josephcabrera-cmyk/Claritone/hardware/schematic/Claritone_Schematic.pdf

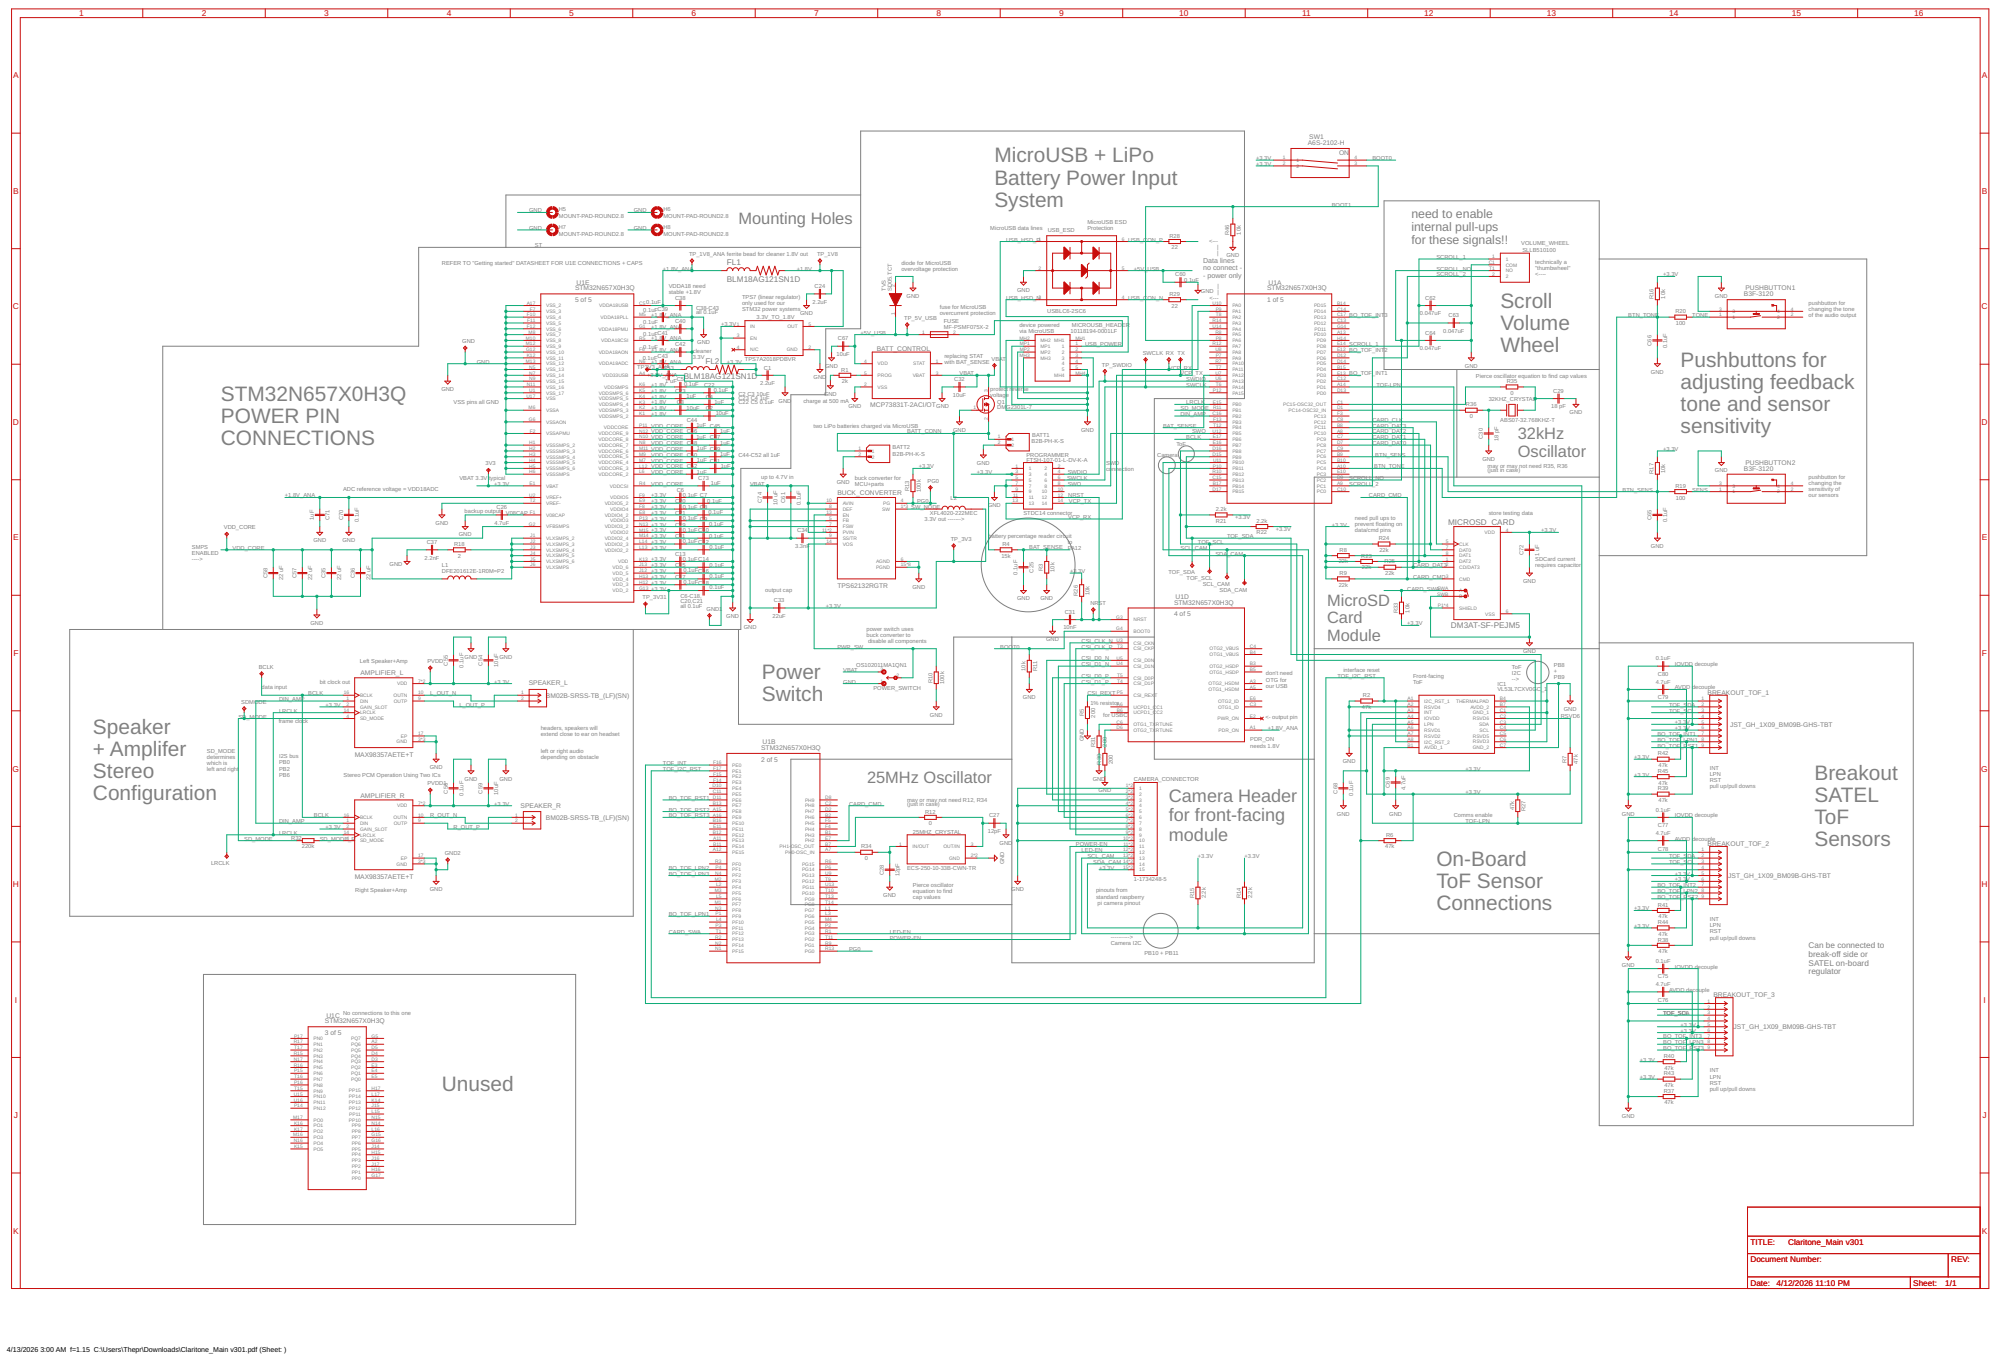
[picture p8: page 1]

ferrite bead for cleaner 1.8V out

REFER TO "Getting started" DATASHEET FOR U1E CONNECTIONS + CAPS

TPS7 (linear regulator)
only used for our STM32 power systems

pushbutton for changing the tone

of the audio output

Pierce oscillator equation to find cap values

VSS pins all GND

two LiPo batteries charged via MicroUSB

may or may not need R35, R36
(just in case)

buck converter for MCU+parts

pushbutton for changing the

need pull ups to
prevent floating on
data/cmd pins

battery percentage reader circuit

SDCard current requires capacitor

don't need
OTG for our USB

headers, speakers will
extend close to ear on headset

left or right audio
depending on obstacle

Stereo PCM Operation Using Two ICs

may or may not need R12, R34

Pierce oscillator equation to find

PF13 R2 | POWER-EN | ----------> Camera I2C PB10 + PB11
PF14 N2 | PG0

Can be connected to
break-off side or
SATEL on-board
regulator

Document Number: | REV:

Date: Date: 4/12/2026 11:10 PM 4/12/2026 11:10 PM | Sheet: Sheet: 1/1 1/1

4/13/2026 3:00 AM f=1.15 C:\Users\Thepr\Downloads\Claritone_Main v301.pdf (Sheet: )
