josephcabrera-cmyk/Claritone/hardware/schematic/Claritone_PCB_BOTTOM.pdf

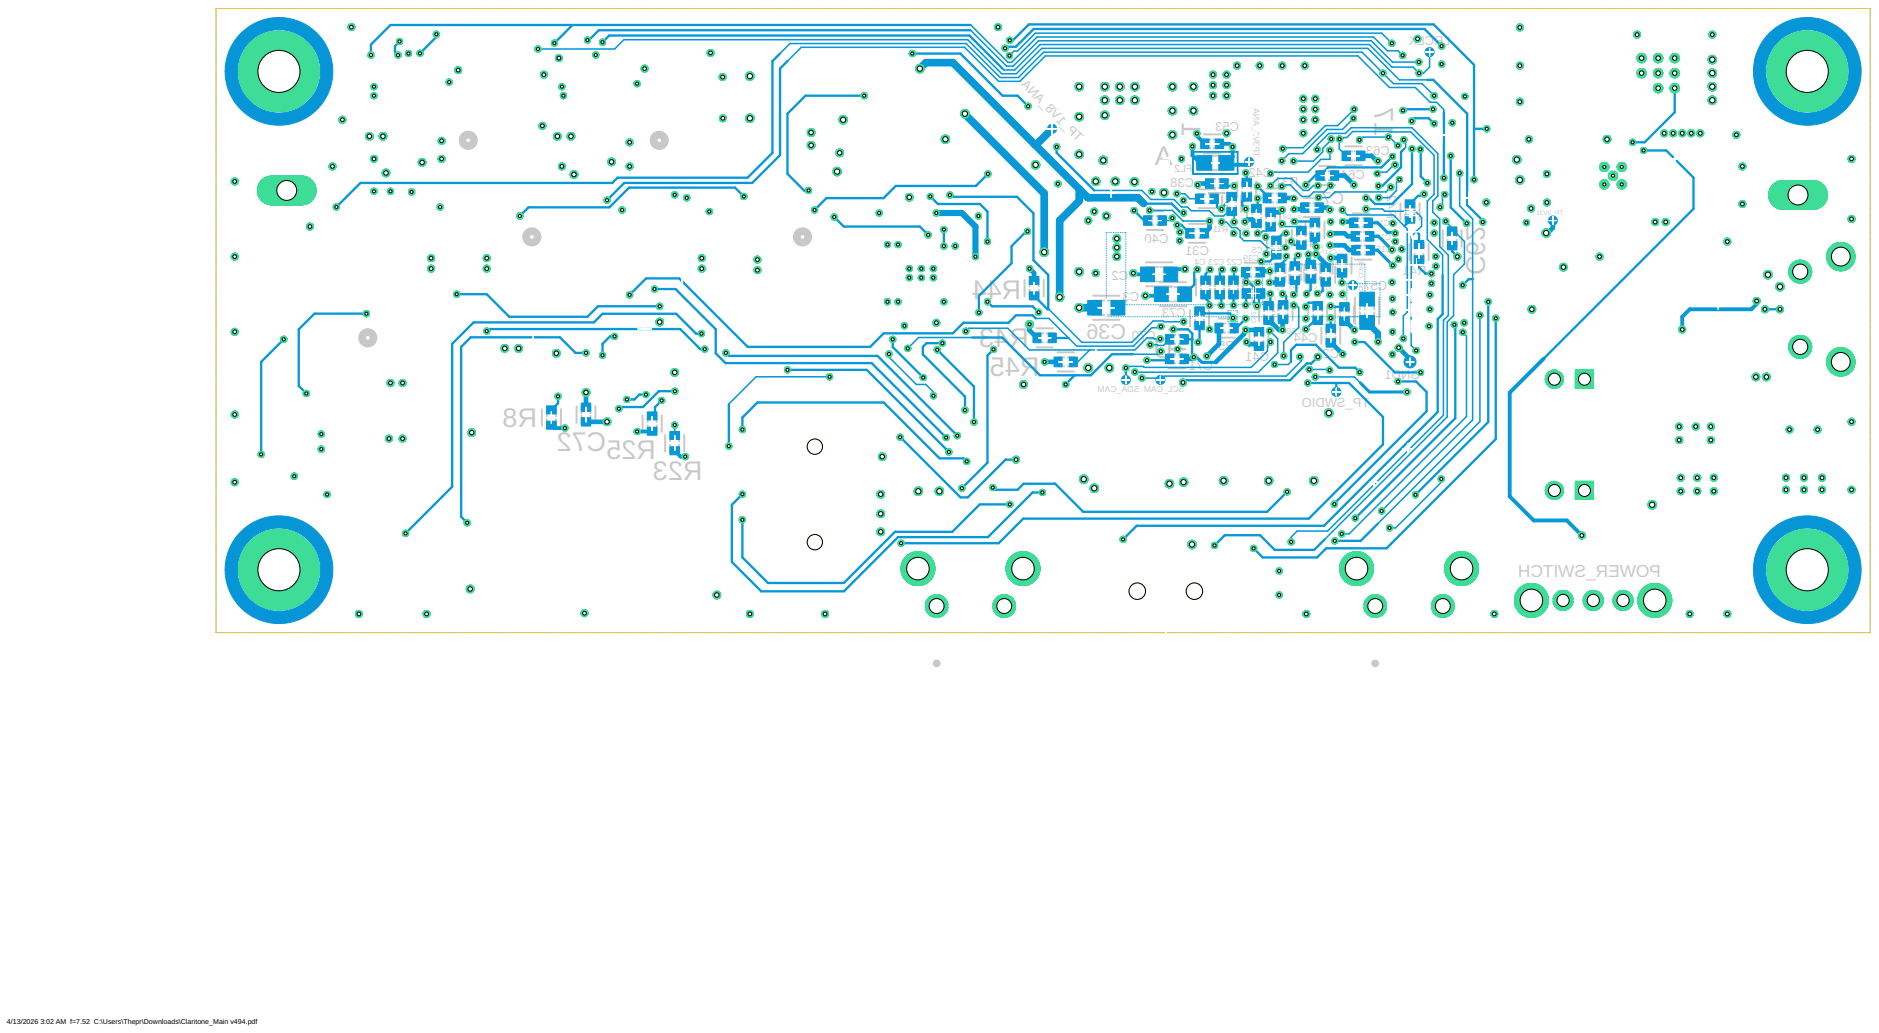
[picture p9: page 1]

4/13/2026 3:02 AM f=7.52 C:\Users\Thepr\Downloads\Claritone_Main v494.pdf
