josephcabrera-cmyk/Claritone/hardware/schematic/Claritone_PCB_TOP.pdf

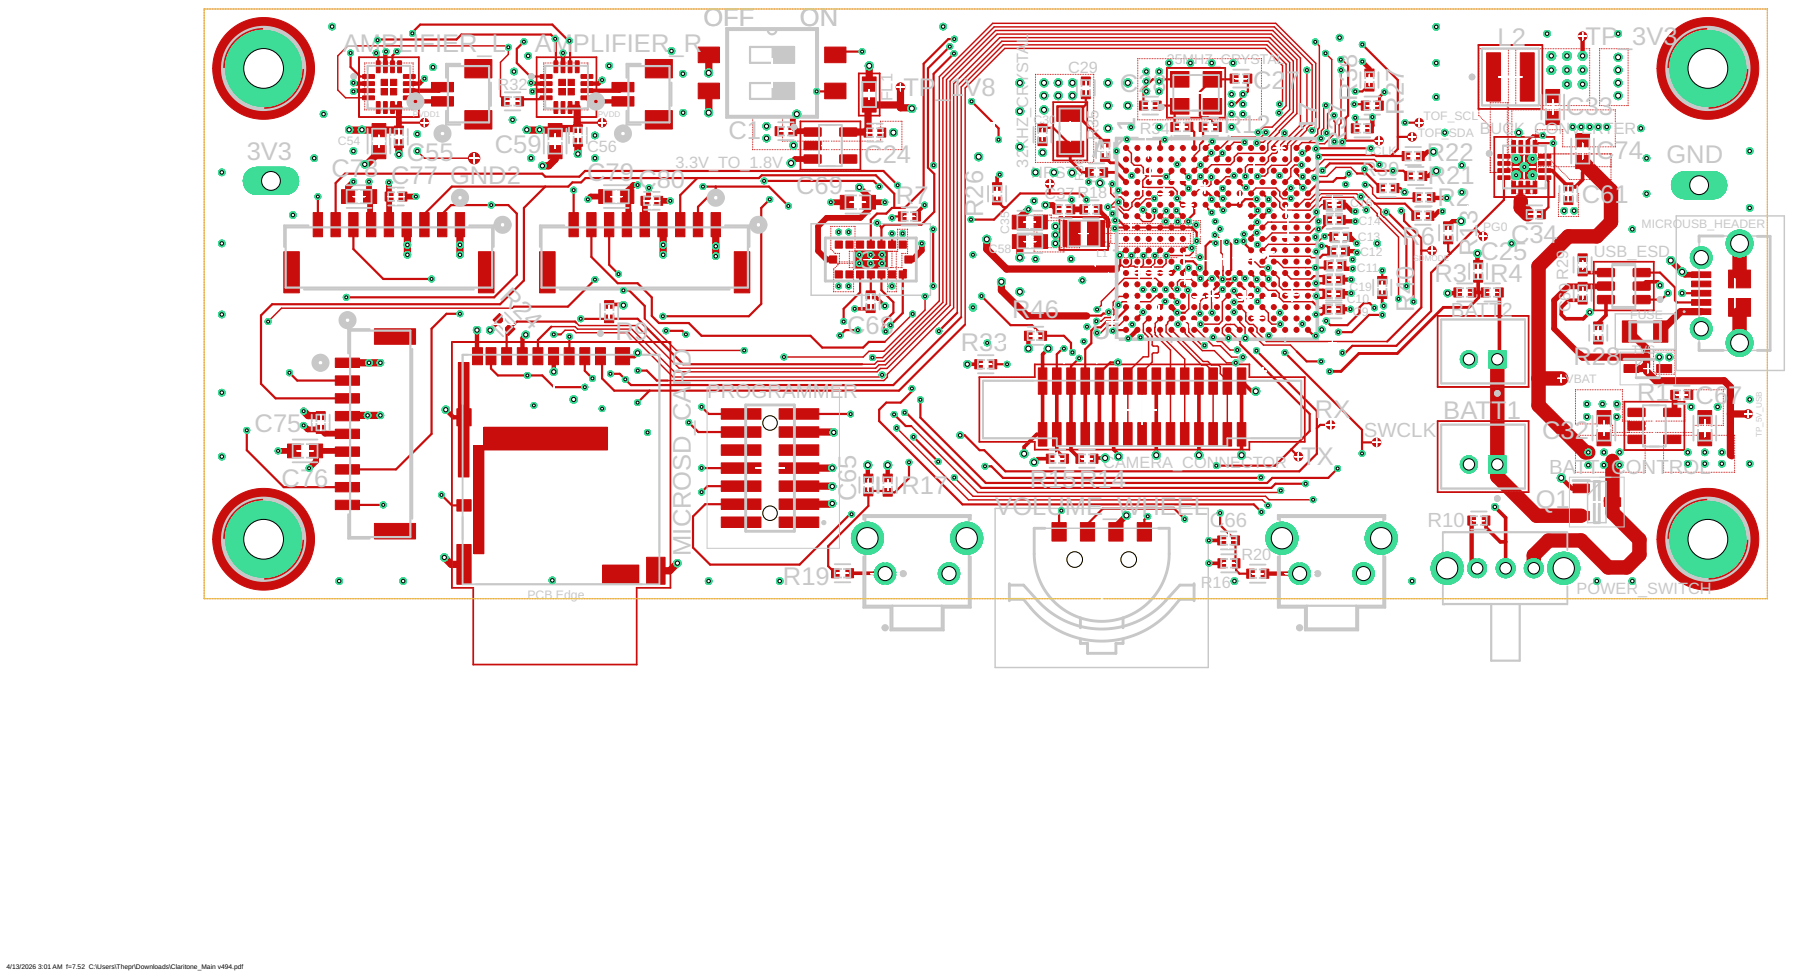
[picture p10: page 1]

4/13/2026 3:01 AM f=7.52 C:\Users\Thepr\Downloads\Claritone_Main v494.pdf
