josephcabrera-cmyk/Claritone/hardware/source/Claritone_Main.brd

## EAGLE design hardware/source/Claritone_Main.brd (2026-10-22)

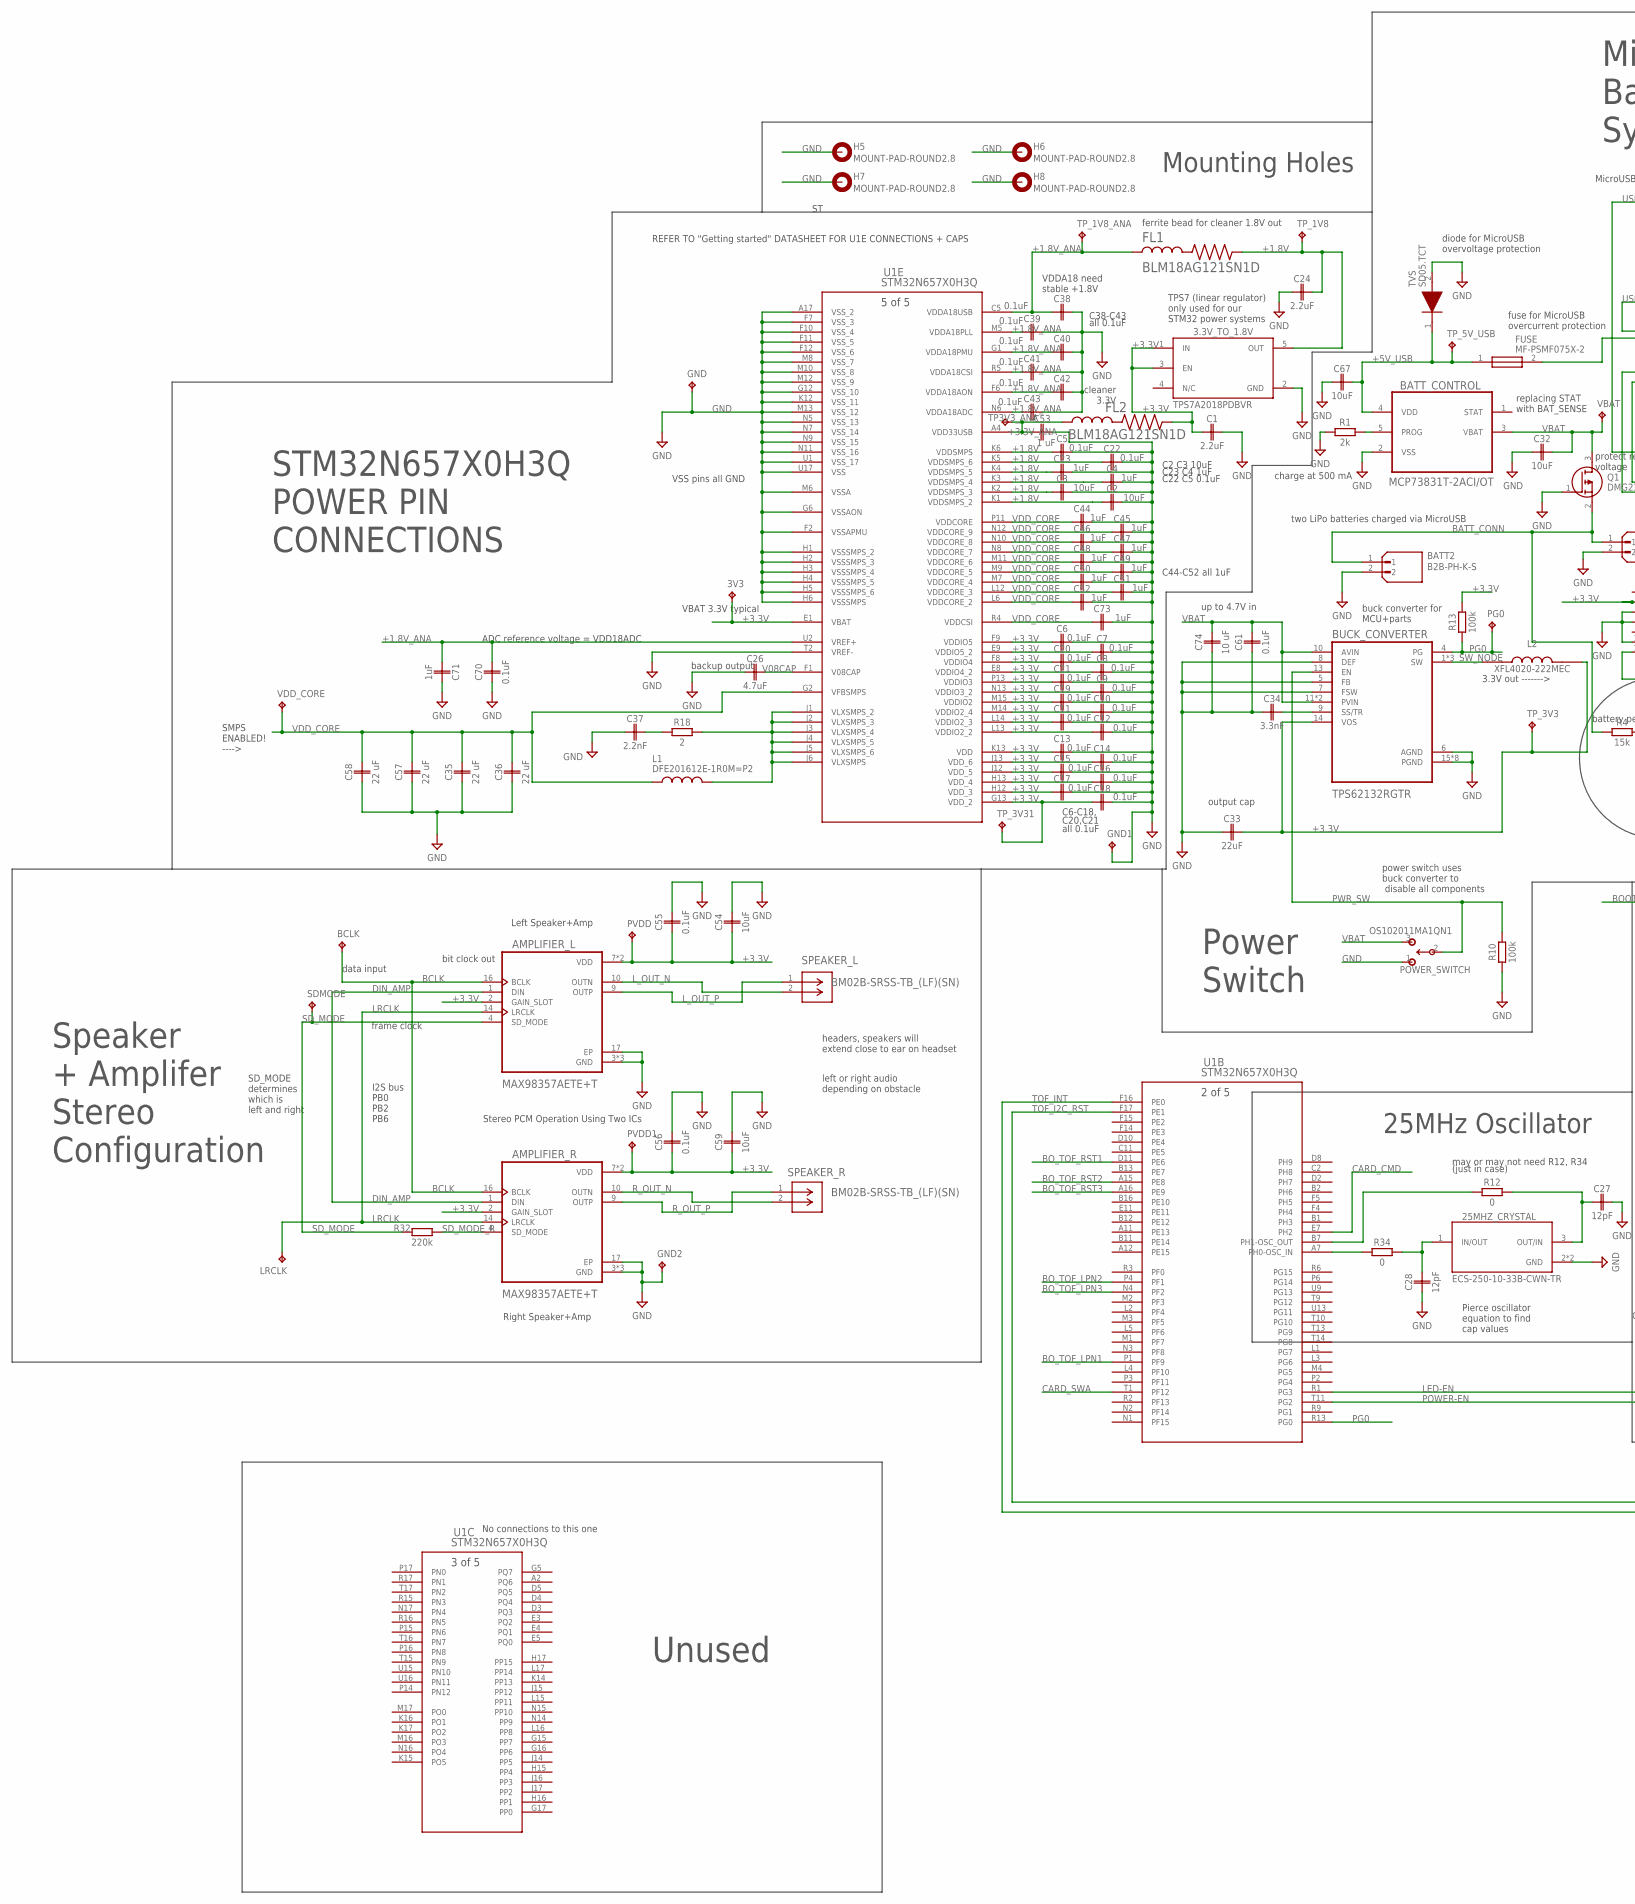
[picture p11: schematic Claritone_Main.sch, part in row 1, column 1]

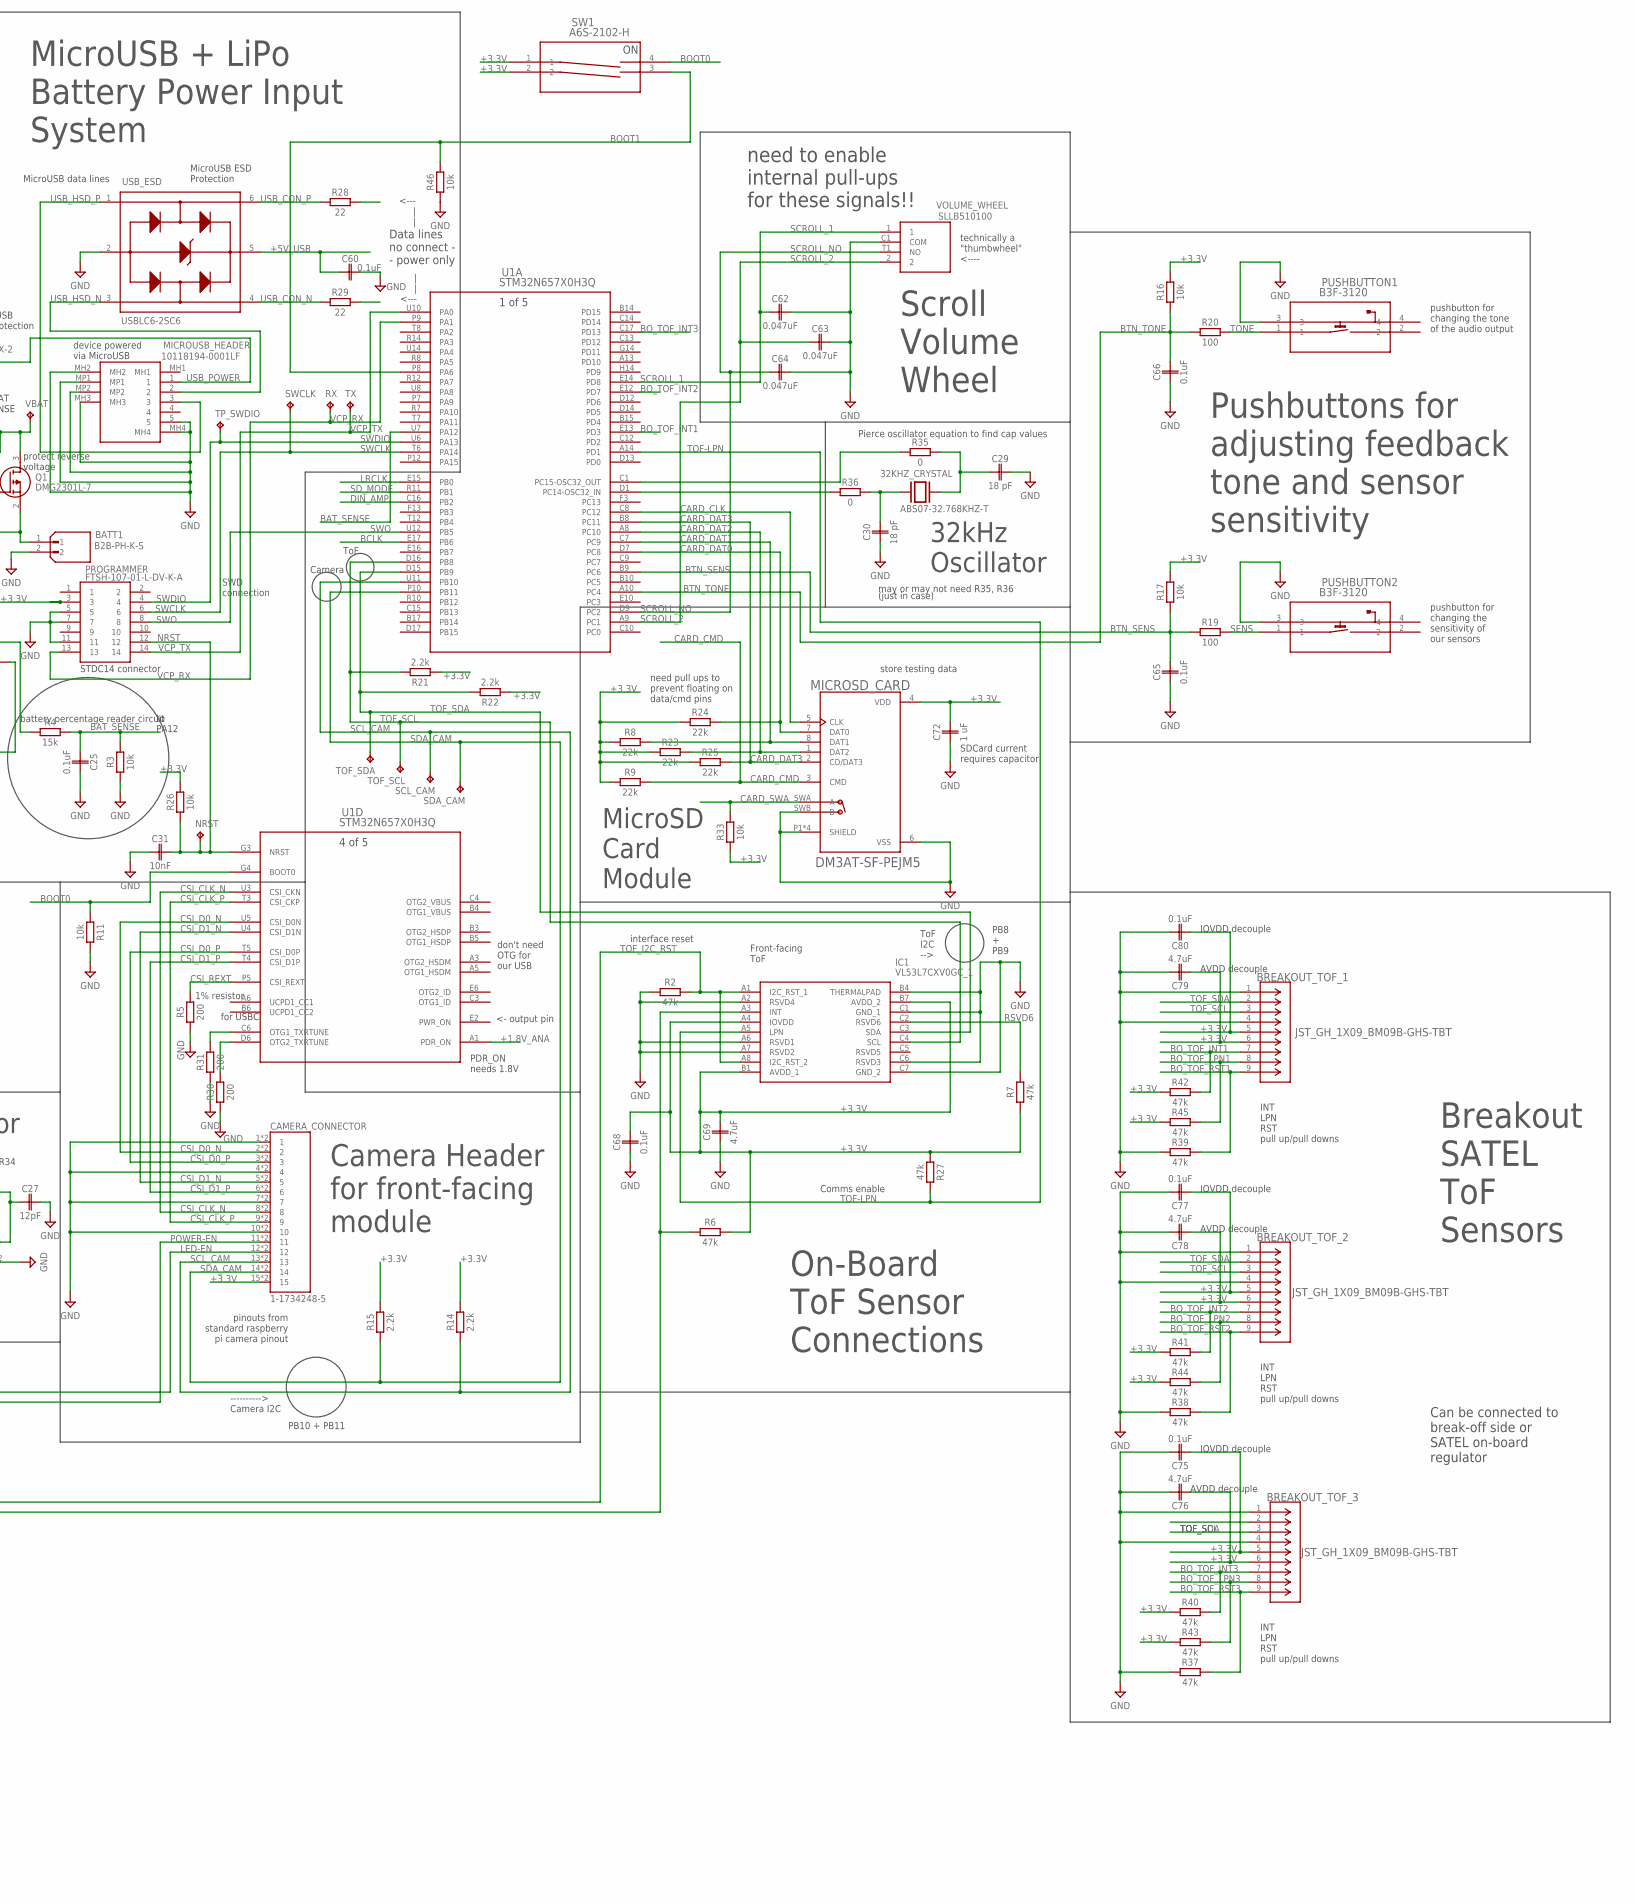
[picture p12: schematic Claritone_Main.sch, part in row 1, column 2]

Parts:
3.3V_TO_1.8V: TPS7A2018PDBVR; SOT95P280X145-5N(3)
3V3: TPPAD1-13Y; P1-13Y
25MHZ_CRYSTAL: ECS-250-10-33B-CWN-TR; XTAL_ECS-250-10-33B-CWN-TR
32KHZ_CRYSTAL: ABS07-32.768KHZ-T; XTAL_ABS07-32.768KHZ-T
AMPLIFIER_L: MAX98357AETE+T; QFN50P300X300X80-17N
AMPLIFIER_R: MAX98357AETE+T; QFN50P300X300X80-17N
BATT1, BATT2: B2B-PH-K-S; JST_B2B-PH-K-S
BATT_CONTROL: MCP73831T-2ACI/OT; SOT95P280X145-5N(1)
BCLK: TPTP06R; TP06R
BREAKOUT_TOF_1, BREAKOUT_TOF_2, BREAKOUT_TOF_3: JST_GH_1X09_BM09B-GHS-TBT; CONN_BM09B-GHS-TBT_JST
BUCK_CONVERTER: TPS62132RGTR; QFN50P300X300X100-17N
C1, C24: 2.2uF; CAPC1005X60
C2, C3, C32, C54, C59, C67: 10uF; CAPC1608X85
C4, C23, C44, C45, C46, C47, C48, C49, C50, C51, C52, C71, C73: 1uF; CAPC1005X60
C5, C6, C7, C8, C9, C10, C11, C12, C13, C14, C15, C16, C17, C18, C19, C20, C21, C22, C25, C38, C39, C40, C41, C42, C43, C55, C56, C60, C61, C65, C66, C68, C70, C75, C77, C80: 0.1uF; CAPC1005X60
C26: 4.7uF; CAPC1005X60
C27, C28: 12pF; CAPC1005X60
C29, C30: 18 pF; CAPC1005X60
C31: 10nF; CAPC1005X60
C33: 22uF; CAPC1608X85
C34: 3.3nF; CAPC1005X60
C35, C36, C57, C58: 22 uF; CAPC1608X85
C37: 2.2nF; CAPC1005X60
C53, C72: 1 uF; CAPC1005X60
C62, C63, C64: 0.047uF; CAPC1005X60
C69, C76, C78, C79: 4.7uF; CAPC1608X85
C74: 10 uF; CAPC1608X85
CAMERA_CONNECTOR: 1-1734248-5; TE_1-1734248-5
FL1, FL2: BLM18AG121SN1D; BEADC1608X95N
FUSE: MF-PSMF075X-2; MFPSMF075X2
GND: TPPAD1-13Y; P1-13Y
GND1, GND2: TPTP08R; TP08R
H5, H6, H7, H8: MOUNT-PAD-ROUND2.8; 2,8-PAD
IC1: VL53L7CXV0GC_1; VL53L7CXV0GC1
L1: DFE201612E-1R0M=P2; INDC2016X120N
L2: XFL4020-222MEC; IND_XFL4020-222MEC
LRCLK: TPTP06R; TP06R
MICROSD_CARD: DM3AT-SF-PEJM5; HRS_DM3AT-SF-PEJM5
MICROUSB_HEADER: 10118194-0001LF; 101181940001LF
NRST: TPTP06R; TP06R
PG0: TPTP06R; TP06R
POWER_SWITCH: OS102011MA1QN1; SWITCH_11MA1QN1
PROGRAMMER: FTSH-107-01-L-DV-K-A; FTSH-107-XX-YYY-DV-K-A
PUSHBUTTON1, PUSHBUTTON2: B3F-3120; SW_B3F-3120_OMR
PVDD, PVDD1: TPTP06R; TP06R
Q1: DMG2301L-7; SOT96P240X115-3N
R1: 2k; RESC1005X40
R2, R6, R7, R27, R37, R38, R39, R40, R41, R42, R43, R44, R45: 47k; RESC1005X40
R3, R11, R16, R17, R26, R33, R46: 10k; RESC1005X40
R4: 15k; RESC1005X40
R5, R30, R31: 200; RESC1005X40
R8, R9, R23, R24, R25: 22k; RESC1005X40
R10, R13: 100k; RESC1005X40
R12, R34, R35, R36: 0; RESC1005X40
R14, R15, R21, R22: 2.2k; RESC1005X40
R18: 2; RESC1005X40
R19, R20: 100; RESC1005X40
R28, R29: 22; RESC1005X40
R32: 220k; RESC1005X40
RX: TPTP06R; TP06R
SCL_CAM: TPTP06R; TP06R
SDA_CAM: TPTP06R; TP06R
SDMODE: TPTP06R; TP06R
SPEAKER_L: BM02B-SRSS-TB_(LF)(SN); CONN_BM02B-SRSS-TB_JST
SPEAKER_R: BM02B-SRSS-TB_(LF)(SN); CONN_BM02B-SRSS-TB_JST
SW1: A6S-2102-H; SW_A6S-2102-H_OMR
SWCLK: TPTP06R; TP06R
TOF_SCL: TPTP06R; TP06R
TOF_SDA: TPTP06R; TP06R
TP3V3_ANA: TPTP06R; TP06R
TP_1V8, TP_1V8_ANA, TP_3V3, TP_3V31, TP_5V_USB: TPTP06R; TP06R
TP_SWDIO: TPTP06R; TP06R
TVS: SD05.TCT; SOD2513X110N
TX: TPTP06R; TP06R
U1: STM32N657X0H3Q; VFBGA264_14X14_STM
USB_ESD: USBLC6-2SC6; SOT95P280X145-6N
VBAT: TPTP06R; TP06R
VDD_CORE: TPTP06R; TP06R
VOLUME_WHEEL: SLLB510100

Connections:
+1.8V: 3.3V_TO_1.8V.5 (OUT), C2.1, C3.1, C4.1, C5.1, C22.1, C23.1, C24.2, FL1.2, TP_1V8.TP, U1.K1 (VDDSMPS_2), U1.K2 (VDDSMPS_3), U1.K3 (VDDSMPS_4), U1.K4 (VDDSMPS_5), U1.K5 (VDDSMPS_6), U1.K6 (VDDSMPS)
+1.8V_ANA: C38.1, C39.1, C40.1, C41.1, C42.1, C43.1, C70.2, C71.1, FL1.1, TP_1V8_ANA.TP, U1.A1 (PDR_ON), U1.C5 (VDDA18USB), U1.F6 (VDDA18AON), U1.G1 (VDDA18PMU), U1.M5 (VDDA18PLL), U1.N6 (VDDA18ADC), U1.R5 (VDDA18CSI), U1.U2 (VREF+)
+3.3V: 3.3V_TO_1.8V.1 (IN), 3.3V_TO_1.8V.3 (EN), 3V3.TP, AMPLIFIER_L.2 (GAIN_SLOT), AMPLIFIER_L.7 (VDD), AMPLIFIER_L.8 (VDD), AMPLIFIER_R.2 (GAIN_SLOT), AMPLIFIER_R.7 (VDD), AMPLIFIER_R.8 (VDD), BREAKOUT_TOF_1.5, BREAKOUT_TOF_1.6, BREAKOUT_TOF_2.5, BREAKOUT_TOF_2.6, BREAKOUT_TOF_3.5, BREAKOUT_TOF_3.6, BUCK_CONVERTER.14 (VOS), C1.1, C6.1, C7.1, C8.1, C9.1, C10.1, C11.1, C12.1, C13.1, C14.1, C15.1, C16.1, C17.1, C18.1, C19.1, C20.1, C21.1, C33.2, C54.1, C55.1, C56.1, C59.1, C68.2, C69.2, C72.2, C75.1, C76.1, C77.1, C78.1, C79.1, C80.1, CAMERA_CONNECTOR.15, CAMERA_CONNECTOR.15_1 (15), FL2.2, IC1.A4 (IOVDD), IC1.B1 (AVDD_1), IC1.B7 (AVDD_2), L2.2, MICROSD_CARD.4 (VDD), PROGRAMMER.3, PVDD.TP, PVDD1.TP, R6.2, R7.1, R8.1, R9.1, R13.2, R14.2, R15.2, R16.2, R17.2, R21.1, R22.1, R23.1, R24.1, R25.1, R26.2, R27.1, R33.1, R40.1, R41.1, R42.1, R43.1, R44.1, R45.1, SW1.1, SW1.2, TP_3V3.TP, TP_3V31.TP, U1.E1 (VBAT), U1.E8 (VDDIO4_2), U1.E9 (VDDIO5_2), U1.F8 (VDDIO4), U1.F9 (VDDIO5), U1.G13 (VDD_2), U1.H12 (VDD_3), U1.H13 (VDD_4), U1.J12 (VDD_5), U1.J13 (VDD_6), U1.K13 (VDD), U1.L13 (VDDIO2_2), U1.L14 (VDDIO2_3), U1.M14 (VDDIO2_4), U1.M15 (VDDIO2), U1.N13 (VDDIO3_2), U1.P13 (VDDIO3)
+3.3V_ANA: C53.1, FL2.1, TP3V3_ANA.TP, U1.A4 (VDD33USB)
+5V_USB: BATT_CONTROL.4 (VDD), C60.1, C67.2, FUSE.1, TP_5V_USB.TP, TVS.1 (K), USB_ESD.5 (VBUS)
BATT_CONN: BATT1.1, BATT2.1, Q1.2 (S), R4.1
BAT_SENSE: C25.1, R3.2, R4.2, U1.U7 (PA12)
BCLK: AMPLIFIER_L.16 (BCLK), AMPLIFIER_R.16 (BCLK), BCLK.TP, U1.E17 (PB6)
BOOT0: R11.1, SW1.4, U1.G4 (BOOT0)
BOOT1: R46.2, SW1.3, U1.P8 (PA6)
BO_TOF_INT1: BREAKOUT_TOF_1.7, R42.2, U1.E13 (PD3)
BO_TOF_INT2: BREAKOUT_TOF_2.7, R41.2, U1.E12 (PD7)
BO_TOF_INT3: BREAKOUT_TOF_3.7, R40.2, U1.C17 (PD13)
BO_TOF_LPN1: BREAKOUT_TOF_1.8, R45.2, U1.P1 (PF9)
BO_TOF_LPN2: BREAKOUT_TOF_2.8, R44.2, U1.P4 (PF1)
BO_TOF_LPN3: BREAKOUT_TOF_3.8, R43.2, U1.N4 (PF2)
BO_TOF_RST1: BREAKOUT_TOF_1.9, R39.2, U1.D11 (PE6)
BO_TOF_RST2: BREAKOUT_TOF_2.9, R38.2, U1.A15 (PE8)
BO_TOF_RST3: BREAKOUT_TOF_3.9, R37.2, U1.A16 (PE9)
BTN_SENS: C65.2, R17.1, R19.1, U1.B9 (PC6)
BTN_TONE: C66.2, R16.1, R20.1, U1.A10 (PC4)
CARD_CLK: MICROSD_CARD.5 (CLK), U1.C8 (PC12)
CARD_CMD: MICROSD_CARD.3 (CMD), R9.2, U1.E7 (PH2)
CARD_DAT0: MICROSD_CARD.7 (DAT0), R24.2, U1.D7 (PC8)
CARD_DAT1: MICROSD_CARD.8 (DAT1), R8.2, U1.C7 (PC9)
CARD_DAT2: MICROSD_CARD.1 (DAT2), R23.2, U1.A8 (PC10)
CARD_DAT3: MICROSD_CARD.2 (CD/DAT3), R25.2, U1.B8 (PC11)
CARD_SWA: MICROSD_CARD.SWA (A), R33.2, U1.T1 (PF12)
CSI_CLK_N: CAMERA_CONNECTOR.8, CAMERA_CONNECTOR.8_1 (8), U1.U3 (CSI_CKN)
CSI_CLK_P: CAMERA_CONNECTOR.9, CAMERA_CONNECTOR.9_1 (9), U1.T3 (CSI_CKP)
CSI_D0_N: CAMERA_CONNECTOR.2, CAMERA_CONNECTOR.2_1 (2), U1.U5 (CSI_D0N)
CSI_D0_P: CAMERA_CONNECTOR.3, CAMERA_CONNECTOR.3_1 (3), U1.T5 (CSI_D0P)
CSI_D1_N: CAMERA_CONNECTOR.5, CAMERA_CONNECTOR.5_1 (5), U1.U4 (CSI_D1N)
CSI_D1_P: CAMERA_CONNECTOR.6, CAMERA_CONNECTOR.6_1 (6), U1.T4 (CSI_D1P)
CSI_REXT: R5.2, U1.P5 (CSI_REXT)
DIN_AMP: AMPLIFIER_L.1 (DIN), AMPLIFIER_R.1 (DIN), U1.C16 (PB2)
GND: 3.3V_TO_1.8V.2 (GND), 25MHZ_CRYSTAL.2 (GND), 25MHZ_CRYSTAL.4 (GND), AMPLIFIER_L.3 (GND), AMPLIFIER_L.11 (GND), AMPLIFIER_L.15 (GND), AMPLIFIER_L.17 (EP), AMPLIFIER_R.3 (GND), AMPLIFIER_R.11 (GND), AMPLIFIER_R.15 (GND), AMPLIFIER_R.17 (EP), BATT1.2, BATT2.2, BATT_CONTROL.2 (VSS), BREAKOUT_TOF_1.1, BREAKOUT_TOF_1.4, BREAKOUT_TOF_2.1, BREAKOUT_TOF_2.4, BREAKOUT_TOF_3.1, BREAKOUT_TOF_3.4, BUCK_CONVERTER.5 (FB), BUCK_CONVERTER.6 (AGND), BUCK_CONVERTER.7 (FSW), BUCK_CONVERTER.8 (DEF), BUCK_CONVERTER.15 (PGND), BUCK_CONVERTER.16 (PGND), BUCK_CONVERTER.17 (PGND), BUCK_CONVERTER.18 (PGND), BUCK_CONVERTER.19 (PGND), BUCK_CONVERTER.20 (PGND), BUCK_CONVERTER.21 (PGND), BUCK_CONVERTER.22 (PGND), C1.2, C2.2, C3.2, C4.2, C5.2, C6.2, C7.2, C8.2, C9.2, C10.2, C11.2, C12.2, C13.2, C14.2, C15.2, C16.2, C17.2, C18.2, C19.2, C20.2, C21.2, C22.2, C23.2, C24.1, C25.2, C26.1, C27.2, C28.1, C29.2, C30.1, C31.1, C32.1, C33.1, C34.1, C35.1, C36.1, C37.1, C38.2, C39.2, C40.2, C41.2, C42.2, C43.2, C44.2, C45.2, C46.2, C47.2, C48.2, C49.2, C50.2, C51.2, C52.2, C53.2, C54.2, C55.2, C56.2, C57.1, C58.1, C59.2, C60.2, C61.1, C62.2, C63.2, C64.2, C65.1, C66.1, C67.1, C68.1, C69.1, C70.1, C71.2, C72.1, C73.2, C74.1, C75.2, C76.2, C77.2, C78.2, C79.2, C80.2, CAMERA_CONNECTOR.1, CAMERA_CONNECTOR.1_1 (1), CAMERA_CONNECTOR.4, CAMERA_CONNECTOR.4_1 (4), CAMERA_CONNECTOR.7, CAMERA_CONNECTOR.7_1 (7), CAMERA_CONNECTOR.10, CAMERA_CONNECTOR.10_1 (10), GND.TP, GND1.TP, GND2.TP, H5.B2,8, H6.B2,8, H7.B2,8, H8.B2,8, IC1.A2 (RSVD4), IC1.A6 (RSVD1), IC1.A7 (RSVD2), IC1.B4 (THERMALPAD), IC1.C1 (GND_1), IC1.C6 (RSVD3), IC1.C7 (GND_2), MICROSD_CARD.6 (VSS), MICROSD_CARD.P1 (SHIELD), MICROSD_CARD.P2 (SHIELD), MICROSD_CARD.P3 (SHIELD), MICROSD_CARD.P4 (SHIELD), MICROSD_CARD.SWB (B), MICROUSB_HEADER.5, MICROUSB_HEADER.MH2, MICROUSB_HEADER.MH3, MICROUSB_HEADER.MH4, MICROUSB_HEADER.MP1, MICROUSB_HEADER.MP2, POWER_SWITCH.1, PROGRAMMER.5, PROGRAMMER.7, PROGRAMMER.11, PUSHBUTTON1.3, PUSHBUTTON2.3, Q1.1 (G), R1.1, R2.1, R3.1, R5.1, R10.1, R11.2, R30.1, R31.1, R37.1, R38.1, R39.1, R46.1, TVS.2 (A), U1.A17 (VSS_2), U1.F2 (VSSAPMU), U1.F7 (VSS_3), U1.F10 (VSS_4), U1.F11 (VSS_5), U1.F12 (VSS_6), U1.G6 (VSSAON), U1.G12 (VSS_10), U1.H1 (VSSSMPS_2), U1.H2 (VSSSMPS_3), U1.H3 (VSSSMPS_4), U1.H4 (VSSSMPS_5), U1.H5 (VSSSMPS_6), U1.H6 (VSSSMPS), U1.K12 (VSS_11), U1.M6 (VSSA), U1.M8 (VSS_7), U1.M10 (VSS_8), U1.M12 (VSS_9), U1.M13 (VSS_12), U1.N5 (VSS_13), U1.N7 (VSS_14), U1.N9 (VSS_15), U1.N11 (VSS_16), U1.T2 (VREF-), U1.U1 (VSS_17), U1.U17 (VSS), USB_ESD.2 (GND), VOLUME_WHEEL.C1 (COM)
LED-EN: CAMERA_CONNECTOR.12, CAMERA_CONNECTOR.12_1 (12), U1.R1 (PG3)
LRCLK: AMPLIFIER_L.14 (LRCLK), AMPLIFIER_R.14 (LRCLK), LRCLK.TP, U1.E15 (PB0)
L_OUT_N: AMPLIFIER_L.10 (OUTN), SPEAKER_L.2
L_OUT_P: AMPLIFIER_L.9 (OUTP), SPEAKER_L.1
unnamed: C37.2, R18.1
unnamed: BATT_CONTROL.5 (PROG), R1.2
unnamed: BUCK_CONVERTER.9 (SS/TR), C34.2
unnamed: 25MHZ_CRYSTAL.3 (OUT/IN), C27.1, R12.2
unnamed: R34.1, U1.A7 (PH0-OSC_IN)
unnamed: 25MHZ_CRYSTAL.1 (IN/OUT), C28.2, R34.2
unnamed: R36.1, U1.D1 (PC14-OSC32_IN)
unnamed: R35.1, U1.C1 (PC15-OSC32_OUT)
unnamed: 32KHZ_CRYSTAL.2, C29.1, R35.2
unnamed: 32KHZ_CRYSTAL.1, C30.2, R36.2
unnamed: R12.1, U1.B7 (PH1-OSC_OUT)
NRST: C31.2, NRST.TP, PROGRAMMER.12, R26.1, U1.G3 (NRST)
OTG1_TXR: R31.2, U1.C6 (OTG1_TXRTUNE)
OTG2_TXR: R30.2, U1.D6 (OTG2_TXRTUNE)
PG0: BUCK_CONVERTER.4 (PG), PG0.TP, R13.1, U1.R13 (PG0)
POWER-EN: CAMERA_CONNECTOR.11, CAMERA_CONNECTOR.11_1 (11), U1.T11 (PG2)
PWR_SW: BUCK_CONVERTER.13 (EN), POWER_SWITCH.2, R10.2
RSVD6: IC1.C2 (RSVD6), R7.2
R_OUT_N: AMPLIFIER_R.10 (OUTN), SPEAKER_R.2
R_OUT_P: AMPLIFIER_R.9 (OUTP), SPEAKER_R.1
SCL_CAM: CAMERA_CONNECTOR.13, CAMERA_CONNECTOR.13_1 (13), R14.1, SCL_CAM.TP, U1.U11 (PB10)
SCROLL_1: C62.1, U1.E14 (PD8), VOLUME_WHEEL.1
SCROLL_2: C63.1, U1.A9 (PC1), VOLUME_WHEEL.2
SCROLL_NO: C64.1, U1.D9 (PC2), VOLUME_WHEEL.T1 (NO)
SDA_CAM: CAMERA_CONNECTOR.14, CAMERA_CONNECTOR.14_1 (14), R15.1, SDA_CAM.TP, U1.P10 (PB11)
SD_MODE: AMPLIFIER_L.4 (SD_MODE), R32.1, SDMODE.TP, U1.R11 (PB1)
SD_MODE_R: AMPLIFIER_R.4 (SD_MODE), R32.2
SENS: PUSHBUTTON2.1, R19.2
SWCLK: PROGRAMMER.6, SWCLK.TP, U1.T6 (PA14)
SWDIO: PROGRAMMER.4, TP_SWDIO.TP, U1.U6 (PA13)
SWO: PROGRAMMER.8, U1.U12 (PB5)
SW_NODE: BUCK_CONVERTER.1 (SW), BUCK_CONVERTER.2 (SW), BUCK_CONVERTER.3 (SW), L2.1
TOF-LPN: IC1.A5 (LPN), R27.2, U1.A14 (PD1)
TOF_I2C_RST: IC1.A1 (I2C_RST_1), IC1.A8 (I2C_RST_2), R2.2, U1.F17 (PE1)
TOF_INT: IC1.A3 (INT), R6.1, U1.F16 (PE0)
TOF_SCL: BREAKOUT_TOF_1.3, BREAKOUT_TOF_2.3, BREAKOUT_TOF_3.3, IC1.C4 (SCL), R21.2, TOF_SCL.TP, U1.D16 (PB8)
TOF_SDA: BREAKOUT_TOF_1.2, BREAKOUT_TOF_2.2, BREAKOUT_TOF_3.2, IC1.C3 (SDA), R22.2, TOF_SDA.TP, U1.D15 (PB9)
TONE: PUSHBUTTON1.1, R20.2
USB_CON_N: R29.1, USB_ESD.4 (I/O2_OUT)
USB_CON_P: R28.1, USB_ESD.6 (I/O1_OUT)
USB_HSD_N: MICROUSB_HEADER.2, USB_ESD.3 (I/O2_IN)
USB_HSD_P: MICROUSB_HEADER.3, USB_ESD.1 (I/O1_IN)
USB_POWER: FUSE.2, MICROUSB_HEADER.1
V08CAP: C26.2, U1.F1 (V08CAP)
VBAT: BATT_CONTROL.3 (VBAT), BUCK_CONVERTER.10 (AVIN), BUCK_CONVERTER.11 (PVIN), BUCK_CONVERTER.12 (PVIN), C32.2, C61.2, C74.2, POWER_SWITCH.3, Q1.3 (D), VBAT.TP
VCP_RX: PROGRAMMER.13, RX.TP, U1.P9 (PA1)
VCP_TX: PROGRAMMER.14, TX.TP, U1.U10 (PA0)
VDD_CORE: C35.2, C36.2, C44.1, C45.1, C46.1, C47.1, C48.1, C49.1, C50.1, C51.1, C52.1, C57.2, C58.2, C73.1, L1.1, U1.G2 (VFBSMPS), U1.L6 (VDDCORE_2), U1.L12 (VDDCORE_3), U1.M7 (VDDCORE_4), U1.M9 (VDDCORE_5), U1.M11 (VDDCORE_6), U1.N8 (VDDCORE_7), U1.N10 (VDDCORE_8), U1.N12 (VDDCORE_9), U1.P11 (VDDCORE), U1.R4 (VDDCSI), VDD_CORE.TP
VLXSMPS: L1.2, R18.2, U1.J1 (VLXSMPS_2), U1.J2 (VLXSMPS_3), U1.J3 (VLXSMPS_4), U1.J4 (VLXSMPS_5), U1.J5 (VLXSMPS_6), U1.J6 (VLXSMPS)

Notes on the sheet:
battery percentage reader circuit
ferrite bead for cleaner 1.8V out
No connections to this one
C44-C52 all 1uF
C6-C18, C20,C21 all 0.1uF
C2 C3 10uF C23 C4 1uF C22 C5 0.1uF
C38-C43 all 0.1uF
cleaner 3.3V
may or may not need R12, R34 (just in case)
VSS pins all GND
VBAT 3.3V typical
ADC reference voltage = VDD18ADC
REFER TO "Getting started" DATASHEET FOR U1E CONNECTIONS + CAPS
VDDA18 need stable +1.8V
TPS7 (linear regulator) only used for our STM32 power systems
PDR_ON needs 1.8V
backup output
SMPS ENABLED! ---->
replacing STAT with BAT_SENSE
fuse for MicroUSB overcurrent protection
diode for MicroUSB overvoltage protection
charge at 500 mA
device powered via MicroUSB
MicroUSB ESD Protection
two LiPo batteries charged via MicroUSB
MicroUSB data lines
to PA12
SWD connection
STDC14 connector
buck converter for MCU+parts
output cap
up to 4.7V in
3.3V out ------->
Stereo PCM Operation Using Two ICs
Left Speaker+Amp
Right Speaker+Amp
SD_MODE determines which is left and right
I2S bus PB0 PB2 PB6
left or right audio depending on obstacle
headers, speakers will extend close to ear on headset
protect reverse voltage
power switch uses buck converter to disable all components
data input
bit clock out
frame clock
1% resistor
Data lines no connect - - power only
don't need OTG for our USB
<- output pin
for USBC
pinouts from standard raspberry pi camera pinout
STM32N657X0H3Q POWER PIN CONNECTIONS
MicroUSB + LiPo Battery Power Input System
Speaker + Amplifer Stereo Configuration
25MHz Oscillator
Camera Header for front-facing module
On-Board ToF Sensor Connections
32kHz Oscillator
Scroll Volume Wheel
Front-facing ToF
----------> Camera I2C
ToF I2C -->
ToF
Camera
PB10 + PB11
PB8 + PB9
Comms enable
MicroSD Card Module
Mounting Holes
Unused
interface reset
Pushbuttons for adjusting feedback tone and sensor sensitivity
Breakout SATEL ToF Sensors
SDCard current requires capacitor
need pull ups to prevent floating on data/cmd pins
store testing data
<--- | |
| | <---
need to enable internal pull-ups for these signals!!
technically a "thumbwheel" <----
Pierce oscillator equation to find cap values
Pierce oscillator equation to find cap values
pushbutton for changing the tone of the audio output
pushbutton for changing the sensitivity of our sensors
IOVDD decouple
AVDD decouple
INT LPN RST pull up/pull downs
Can be connected to break-off side or SATEL on-board regulator
may or may not need R35, R36 (just in case)
Power Switch

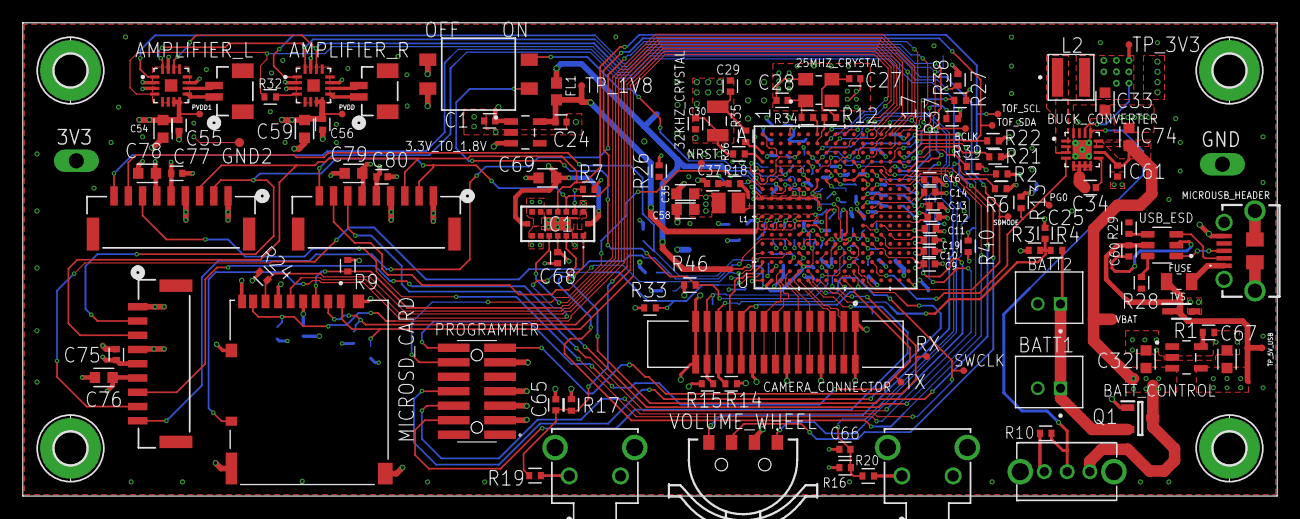
[picture p13: board Claritone_Main.brd from above]

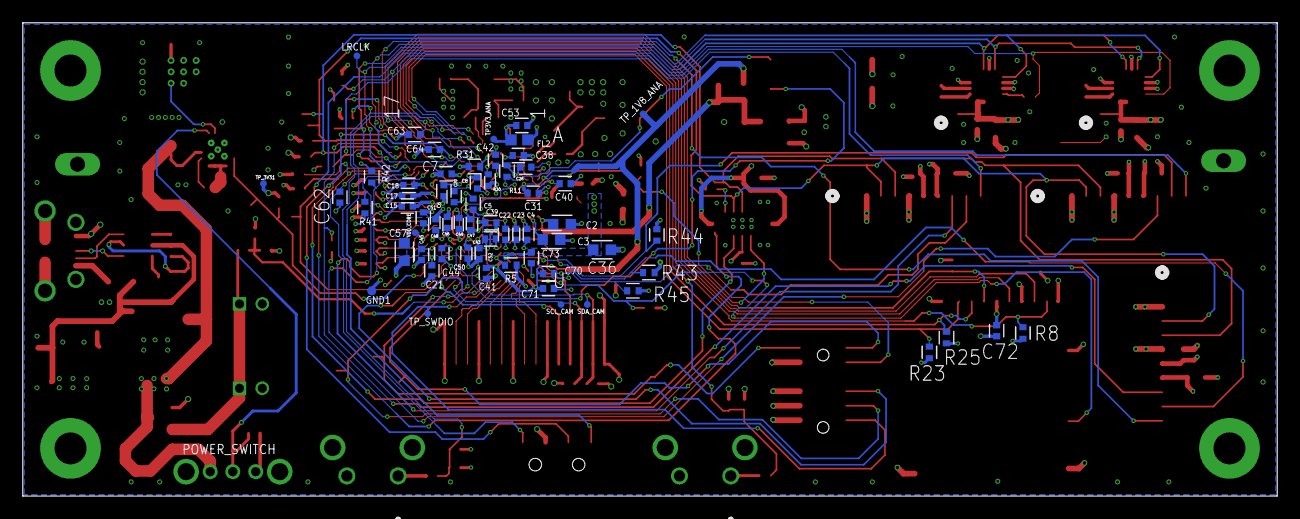
[picture p14: board Claritone_Main.brd from below]

Board: 4 copper layers, 110.0 x 41.5 mm, 190 parts (63 on the bottom side), 90 nets.
