josephcabrera-cmyk/Claritone/FSBL/Src/main.c

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
/* Includes ------------------------------------------------------------------*/
#include "main.h"

/* USER CODE BEGIN Includes */
#include "extmem.h"

/* USER CODE END Includes */


XSPI_HandleTypeDef hxspi2;

void SystemClock_Config(void);
static void MX_GPIO_Init(void);
static void MX_XSPI2_Init(void);
/* USER CODE BEGIN PFP */
void Error_Handler(void);
#ifndef NO_OTP_FUSE
static int32_t OTP_Config(void);
#endif /* NO_OTP_FUSE */
/* USER CODE END PFP */

/**
  * @brief  The application entry point.
  * @retval int
  */
int main(void)
{

  /* Enable the CPU Cache */

  /* Enable I-Cache---------------------------------------------------------*/
  SCB_EnableICache();

  /* Enable D-Cache---------------------------------------------------------*/
  SCB_EnableDCache();

  /* MCU Configuration--------------------------------------------------------*/
  HAL_Init();

  /* Configure the system clock */
  SystemClock_Config();

  /* USER CODE BEGIN SysInit */
#ifndef NO_OTP_FUSE
  /* Set OTP fuses for XSPI IO pins speed optimization */
  if(OTP_Config() != 0){
    Error_Handler();
  }
#endif /* NO_OTP_FUSE */
  /* USER CODE END SysInit */

  /* Initialize all configured peripherals */
  MX_GPIO_Init();
  MX_XSPI2_Init();
  /* USER CODE BEGIN 2 */
  /* Initialise the serial memory */
  MX_EXTMEM_Init();

  BOOT_Application();
  /* We should never get here as execution is now from user application */
  /* USER CODE END 2 */

  /* Infinite loop */
  /* USER CODE BEGIN WHILE */
  while (1)
  {
     __NOP();
    /* USER CODE END WHILE */

    /* USER CODE BEGIN 3 */
  }
  /* USER CODE END 3 */
}
/* USER CODE BEGIN CLK 1 */
 /*         The system Clock is configured as follows :
  *            CPU Clock source               = IC1_CK
  *            System bus Clock source        = IC2_IC6_IC11_CK
  *            CPUCLK (sysa_ck) (Hz)          = 600000000
  *            SYSCLK AXI (sysb_ck) (Hz)      = 400000000
  *            SYSCLK NPU (sysc_ck) (Hz)      = 300000000
  *            SYSCLK AXISRAM3/4/5/6 (sysd_ck) (Hz) = 400000000
  *            HCLKx(Hz)                      = 200000000
  *            PCLKx(Hz)                      = 200000000
  *            AHB Prescaler                  = 2
  *            APB1 Prescaler                 = 1
  *            APB2 Prescaler                 = 1
  *            APB4 Prescaler                 = 1
  *            APB5 Prescaler                 = 1
  *            PLL1 State                     = ON
  *            PLL1 clock source              = HSI
  *            PLL1 M                         = 4
  *            PLL1 N                         = 75
  *            PLL1 P1                        = 1
  *            PLL1 P2                        = 1
  *            PLL1 FRACN                     = 0
  *            PLL2 State                     = BYPASS
  *            PLL2 clock source              = HSI
  *            PLL3 State                     = BYPASS
  *            PLL3 clock source              = HSI
  *            PLL4 State                     = BYPASS
  *            PLL4 clock source              = HSI
  */
/* USER CODE END CLK 1 */

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
/* USER CODE BEGIN 4 */
#ifndef NO_OTP_FUSE
/**
  * @brief  User OTP fuse Configuration
  *         The User Option Bytes are configured as follows :
  *            VDDIO_HSLV = 1 (enable the configuration of pads below 2.5V,
  *                            I/O speed otpmization at low-voltage allowed)
  *            XSPI1_HSLV = 1 (enable I/O XSPIM Port 1 high-speed option)
  *            XSPI2_HSLV = 1 (enable I/O XSPIM Port 2 high-speed option)
  *            Other User Option Bytes remain unchanged
  * @retval None
  */
static int32_t OTP_Config(void)
{
  #define BSEC_HW_CONFIG_ID        124U
  #define BSEC_HWS_HSLV_VDDIO3     (1U<<15)

  uint32_t fuse_id, bit_mask, data;
  BSEC_HandleTypeDef sBsecHandler;
  int32_t retr = 0;

  __HAL_RCC_SYSCFG_CLK_ENABLE();
  __HAL_RCC_BSEC_CLK_ENABLE();

  sBsecHandler.Instance = BSEC;

  /* Read current value of fuse */
  fuse_id = BSEC_HW_CONFIG_ID;
  if (HAL_BSEC_OTP_Read(&sBsecHandler, fuse_id, &data) == HAL_OK)
  {
    /* Check if bit has already been set */
    bit_mask = BSEC_HWS_HSLV_VDDIO3 ;
    if ((data & bit_mask) != bit_mask)
    {
      data |= bit_mask;
      /* Bitwise programming of lower bits */
      if (HAL_BSEC_OTP_Program(&sBsecHandler, fuse_id, data, HAL_BSEC_NORMAL_PROG) == HAL_OK)
      {
        /* Read lower bits to verify the correct programming */
        if (HAL_BSEC_OTP_Read(&sBsecHandler, fuse_id, &data) == HAL_OK)
        {
          if ((data & bit_mask) != bit_mask)
          {
            /* Error : Fuse programming not taken in account */
            retr = -1;
          }
        }
        else
        {
          /* Error : Fuse read unsuccessful */
          retr = -2;
        }
      }
      else
      {
        /* Error : Fuse programming unsuccessful */
        retr = -3;
      }
    }
  }
  else
  {
    /* Error  : Fuse read unsuccessful */
    retr = -4;
  }
  return retr;
}
#endif /* NO_OTP_FUSE */
/* USER CODE END 4 */
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
