josephcabrera-cmyk/Claritone/(commit log)

2026-10-21 Losslessly recompress schematic and PCB images
    Re-saved with standard PNG compression: about 75 MB down to 0.8 MB, pixel-identical.
2026-10-21 Clean up BOM and rename to claritone-bom
    Fix typos and the stale STM32N655L0H3Q part number, and replace the course
    revision notes with a one-line design note per part. CSV and XLSX match.
2026-10-21 Document the spatial audio prototype and add .gitignore
    Replace Spatial-Sound/Text.txt with a README covering the audio cues, a
    verified Linux build command, and the controls.
2026-10-22 Replace template firmware with the board's STM32N657 projects
    Imports the bring-up projects L0-L8 and Claritone_Main (firmware by Joseph
    and Sola) from Niefr1/Blindsight-Claritone-Senior-Design at 7aa2455, plus
    Joseph's April 28 stereo panning version of L7 as a variant. Only
    application sources and .ioc files are kept; CubeMX regenerates the rest.
    Removes the NUCLEO LED template and the old NUCLEO ToF test.
2026-10-22 Move the spatial audio prototype to prototypes/ and credit Sola
2026-10-22 Rewrite README around what ran at the showcase
    Adds a photo of the assembled board, separates the showcase build from
    the designed system, drops the speed claim, and updates team credits.
2026-10-22 Add EAGLE schematic and board files
