josephcabrera-cmyk/Claritone/(notices)

Notices in the files:
FSBL/Src/main.c:
Copyright (c) 2025 STMicroelectronics.
All rights reserved.
This software is licensed under terms that can be found in the LICENSE file
parts and their libraries:
Claritone_Lib: COPYRIGHT: Copyright (C) 2026 Ultra Librarian. All rights reserved.
